somepin/milk-crate/case/milkcrate-pcb-mount.step

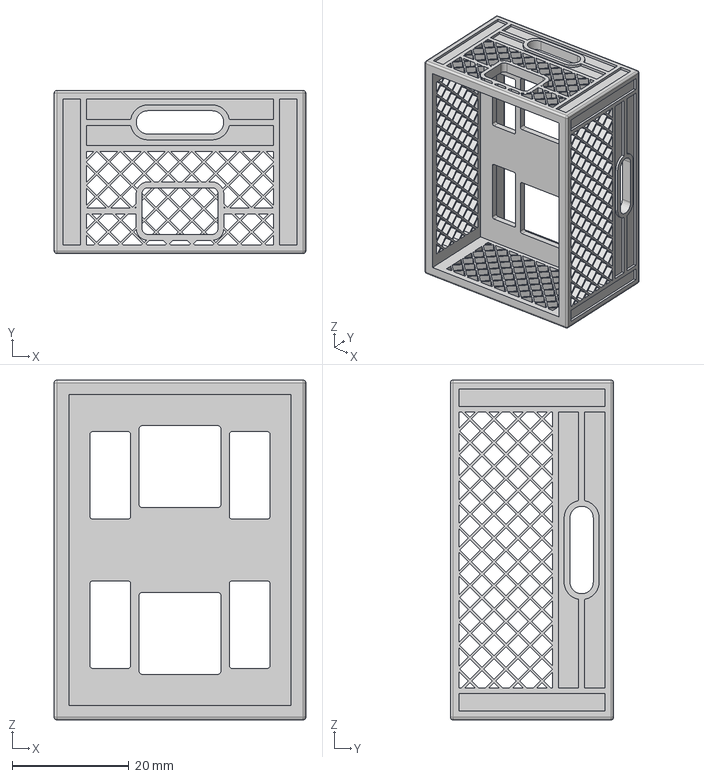
[picture p3: CAD file, 2021-08-17]
case/milkcrate-pcb-mount.step
43.1 x 28.0 x 58.2 mm
