somepin/milk-crate/(list of files, cad)

Other CAD files:
case/milkcrate-plate-mount.step
case/milkcrate-pcb-mount.stl
case/milkcrate-plate-mount.stl
