somepin/milk-crate/kicad/milkcrate.kicad_pcb

## KiCad design kicad/milkcrate.kicad_pcb (2021-08-17)

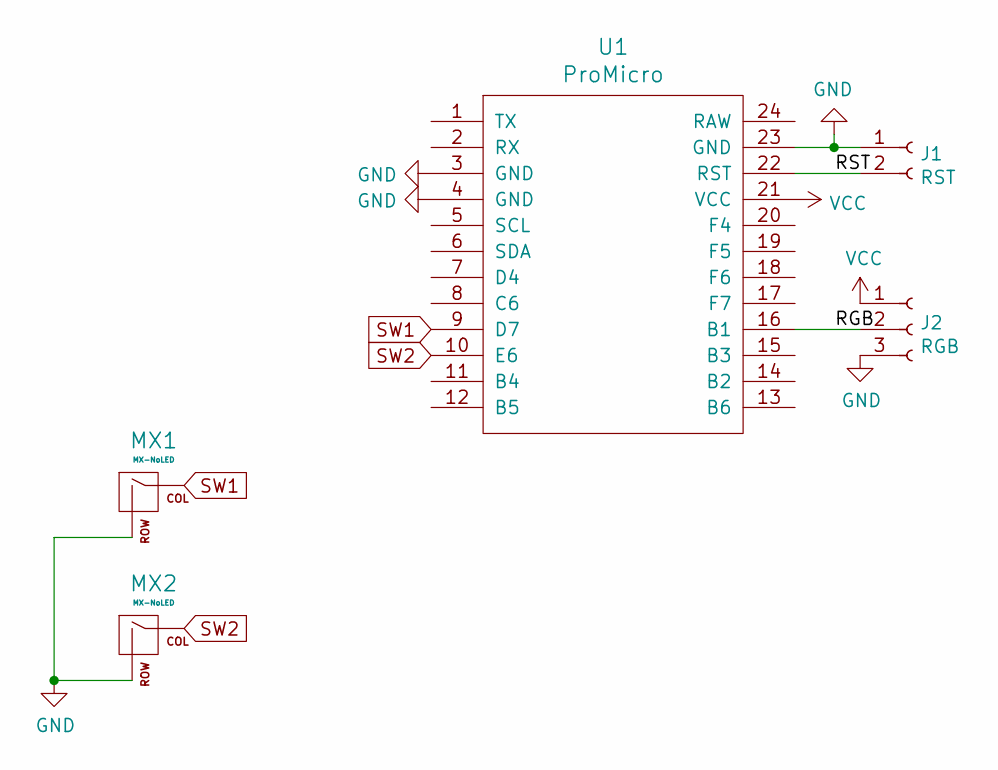
[picture p4: schematic milkcrate.sch]

Parts:
J1: RST; PinHeader_1x02_P2.54mm_Vertical
J2: RGB; PinHeader_1x03_P2.54mm_Vertical
MX1, MX2: MX-NoLED; MXOnly-ISO-ReversedStabilizers-NoLED
U1: ProMicro; ProMicro-NoSilk

Connections:
/RGB: J2.2, U1.16 (B1)
/RST: J1.2, U1.22 (RST)
GND: J1.1, J2.3, MX1.2 (ROW), MX2.2 (ROW), U1.3 (GND), U1.4 (GND), U1.23 (GND)
SW1: MX1.1 (COL), U1.9 (D7)
SW2: MX2.1 (COL), U1.10 (E6)
VCC: J2.1, U1.21 (VCC)

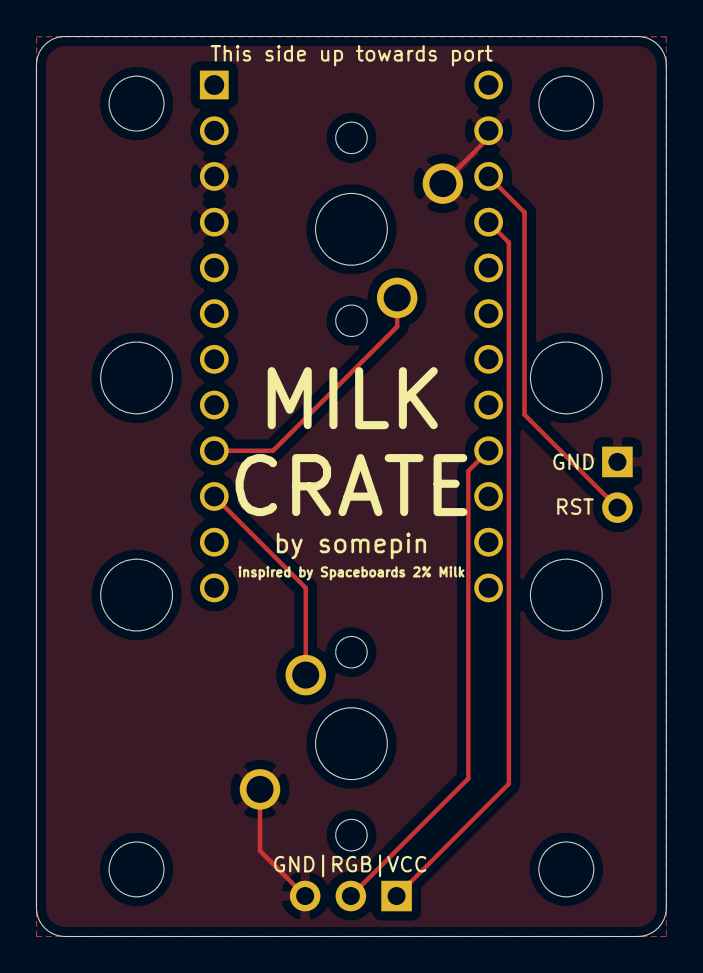
[picture p5: board milkcrate.kicad_pcb from above]

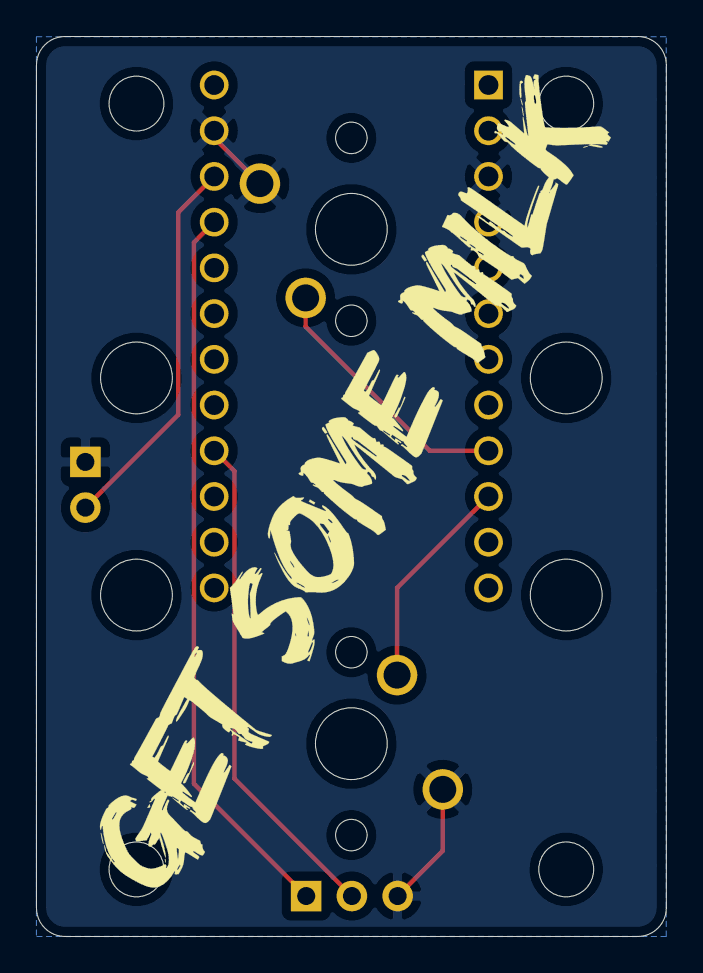
[picture p6: board milkcrate.kicad_pcb from below]

Board: 2 copper layers, 35.0 x 50.0 mm, 5 parts (2 on the bottom side), 6 nets.
