somepin/milk-crate/firmware/config.h

/* Copyright 2021 somepin
 *
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
 * You should have received a copy of the GNU General Public License
 * along with this program.  If not, see <http://www.gnu.org/licenses/>.
 */
#pragma once
#include "config_common.h"

/* USB Device descriptor parameter */
#define VENDOR_ID       0x7370 // "SP"
#define PRODUCT_ID      0x6D63 // "MC"
#define DEVICE_VER      0x0001
#define MANUFACTURER    somepin
#define PRODUCT         Milk Crate

/* key matrix size */
#define MATRIX_ROWS 2
#define MATRIX_COLS 1

/* Milk default pinout */
#define DIRECT_PINS { \
    {D7}, \
    {E6}  \
}
#define UNUSED_PINS

#ifdef RGBLIGHT_ENABLE
#define RGB_DI_PIN B1
#define RGBLED_NUM 1
#define RGBLIGHT_EFFECT_BREATHING
#define RGBLIGHT_EFFECT_RAINBOW_MOOD
#define RGBLIGHT_EFFECT_CHRISTMAS
#define RGBLIGHT_EFFECT_ALTERNATING
#define RGBLIGHT_EFFECT_TWINKLE
#define RGBLIGHT_SLEEP
#endif
