somepin/milk-crate/(commit log)

2021-08-17 add kicad pcb files and gerbers
    [milkcrate-B_Cu.gbl, milkcrate-B_Mask.gbs, milkcrate-B_SilkS.gbo, milkcrate-Edge_Cuts.gm1, milkcrate-F_Cu.gtl, milkcrate-F_Mask.gts, milkcrate-F_SilkS.gto, milkcrate-NPTH.drl]
2021-08-17 add case stls and step
    [milkcrate-pcb-mount.step, milkcrate-pcb-mount.stl, milkcrate-plate-mount.step, milkcrate-plate-mount.stl]
